OE5XRX/HW-DebugBoard/doc/index.md

---
title: DebugBoard
nav_order: 1
parent: Hardware
---

# DebugBoard PCB

<table>
  <tr><th>Top</th><th>Bottom</th></tr>
  <tr>
    <td>top</td>
    <td>bottom</td>
  </tr>
</table>

Some Text

## Daten

- [Schaltplan]({{ site.data.project.name }}-schematic.pdf)
- [BOM]({{ site.data.project.name }}-bom.html)
- [iBOM]({{ site.data.project.name }}-ibom.html)
- [JLCPCB fabrication & stencil](JLCPCB/{{ site.data.project.name }}-_JLCPCB_compress.zip)
- [JLCPCB Bom](JLCPCB/{{ site.data.project.name }}_bom_jlc.csv)
- [JLCPCB Pick&Place](JLCPCB/{{ site.data.project.name }}_cpl_jlc.csv)
