OE5XRX/HW-DebugBoard/DebugBoard.kicad_sch

## KiCad design DebugBoard.kicad_sch (2026-05-12)

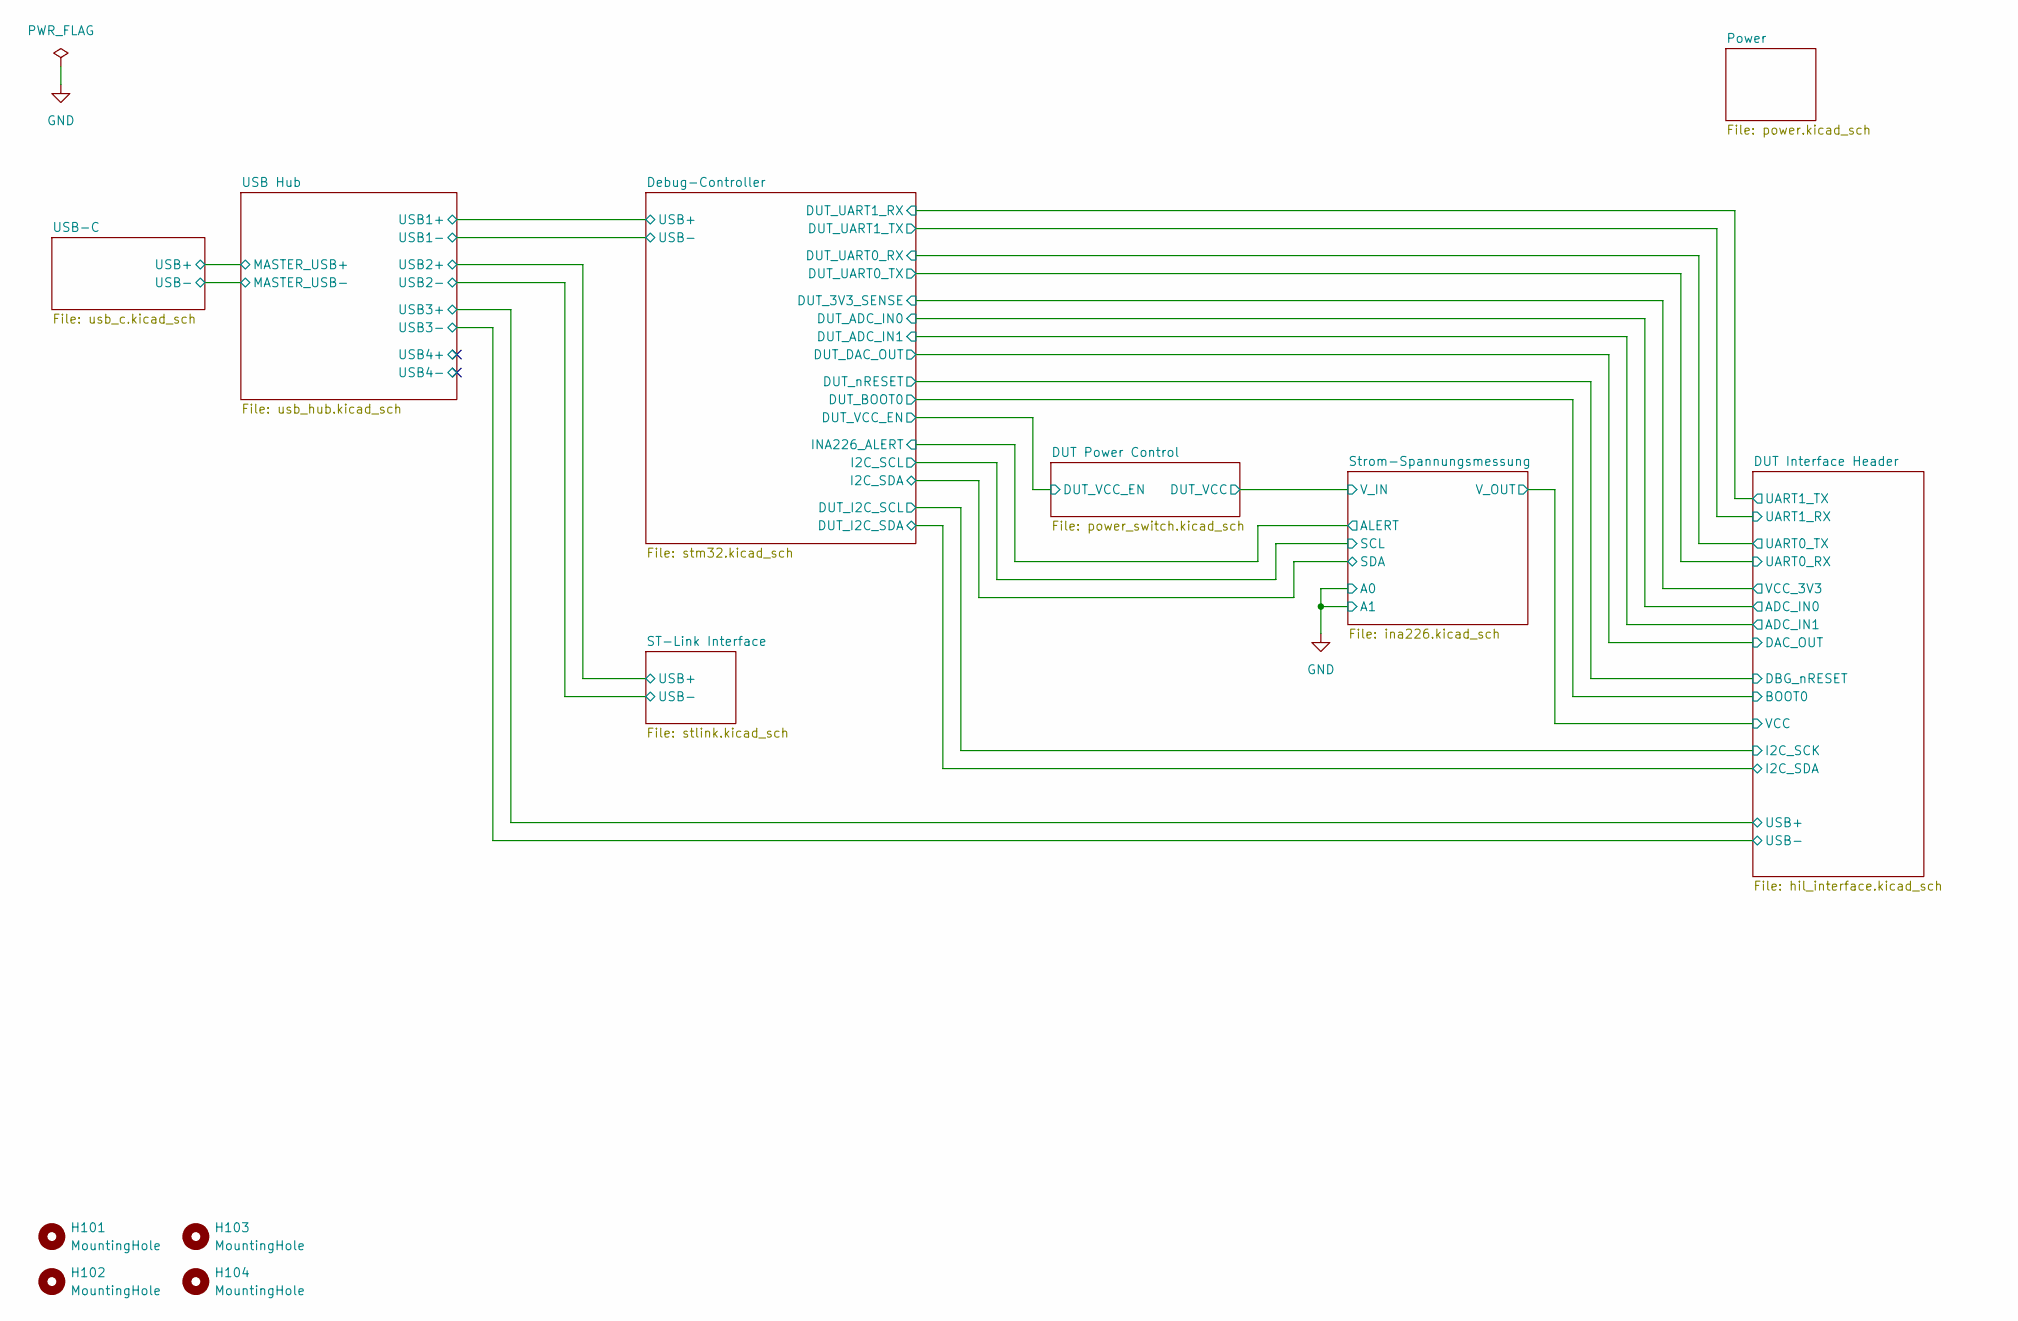
[picture p1: schematic DebugBoard.kicad_sch]

Parts:
H101, H102, H103, H104: MountingHole; MountingHole_3.2mm_M3
