OE5XRX/HW-DebugBoard/hil_interface.kicad_sch

## KiCad design hil_interface.kicad_sch (2026-05-12)

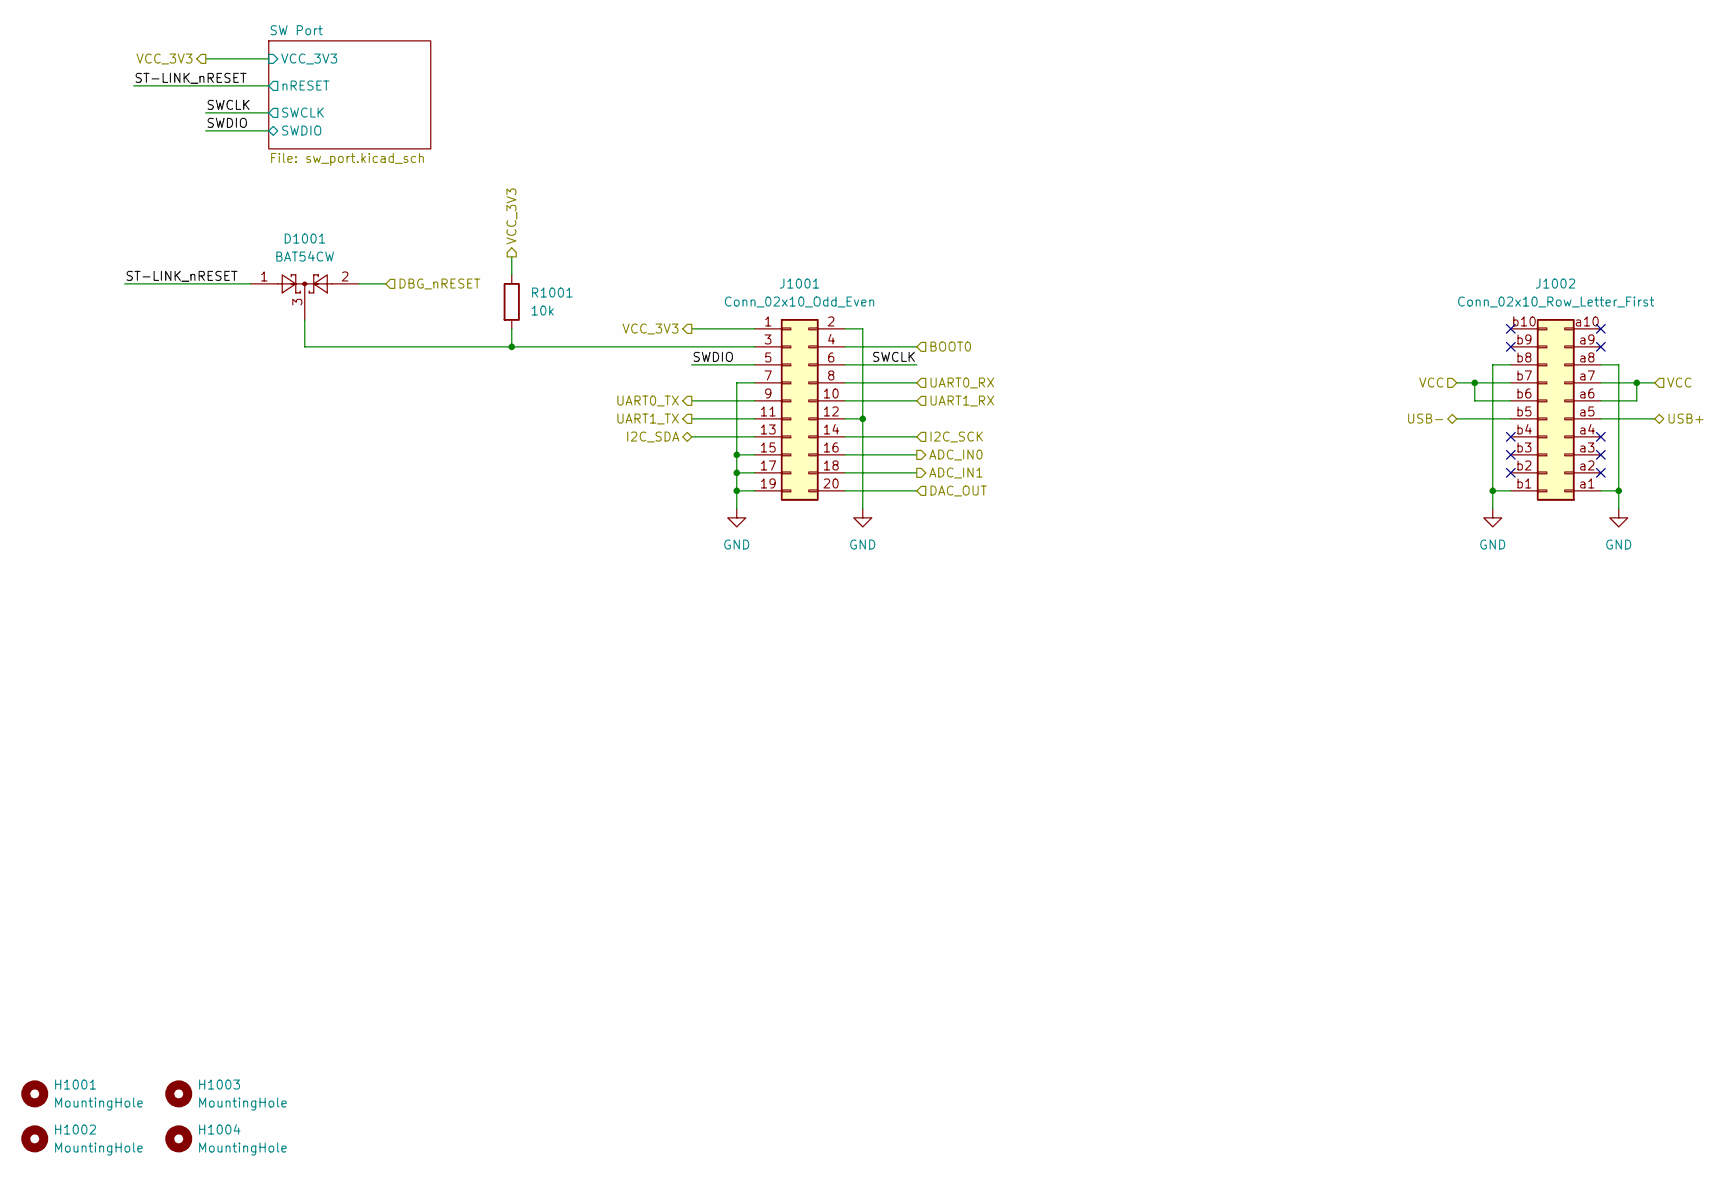
[picture p2: schematic hil_interface.kicad_sch]

Parts:
D1001: BAT54CW; SOT-323_SC-70
H1001, H1002, H1003, H1004: MountingHole; MountingHole_3.2mm_M3
J1001: Conn_02x10_Odd_Even
J1002: Conn_02x10_Row_Letter_First; PCN10-20P-2.54DS; MOUSER 798-PCN1020P254DS72
R1001: 10k; R_0805_2012Metric

Connections:
ADC_IN0: J1001.16
ADC_IN1: J1001.18
BOOT0: J1001.4
DAC_OUT: J1001.20
DBG_nRESET: D1001.2
GND: J1001.2, J1001.7, J1001.12, J1001.15, J1001.17, J1001.19, J1002.a1, J1002.a8, J1002.b1, J1002.b8
I2C_SCK: J1001.14
I2C_SDA: J1001.13
unnamed: D1001.3, J1001.3, R1001.2
ST-LINK_nRESET: D1001.1
SWCLK: J1001.6
SWDIO: J1001.5
UART0_RX: J1001.8
UART0_TX: J1001.9
UART1_RX: J1001.10
UART1_TX: J1001.11
USB+: J1002.a5
USB-: J1002.b5
VCC: J1002.a6, J1002.a7, J1002.b6, J1002.b7
VCC_3V3: J1001.1, R1001.1
