OE5XRX/HW-DebugBoard/ina226.kicad_sch

## KiCad design ina226.kicad_sch (2026-05-12)

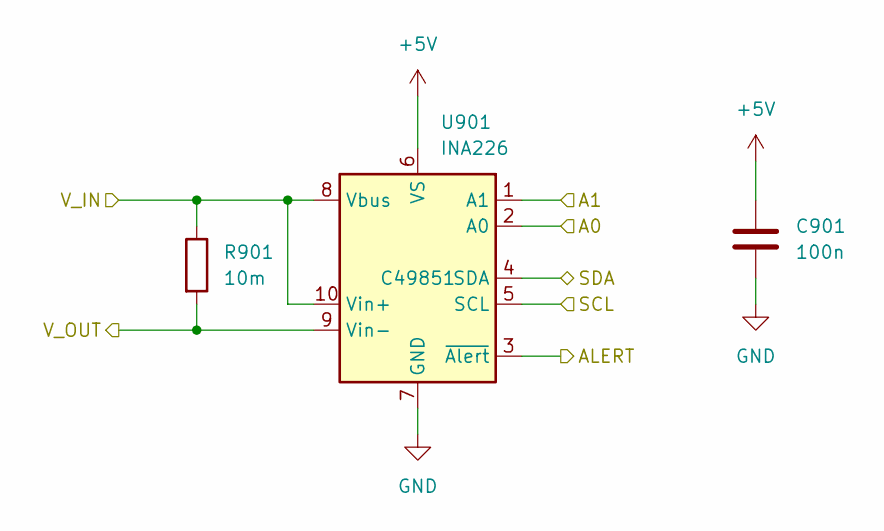
[picture p3: schematic ina226.kicad_sch]

Parts:
C901: 100n; C_0805_2012Metric; LCSC C28233
R901: 10m; R_2512_6332Metric; MOUSER 652-CRF2512FZR010ELF
U901: INA226; VSSOP-10_3x3mm_P0.5mm; LCSC C49851

Connections:
+5V: C901.1, U901.6 (VS)
A0: U901.2 (A0)
A1: U901.1 (A1)
ALERT: U901.3 (~Alert)
GND: C901.2, U901.7 (GND)
SCL: U901.5 (SCL)
SDA: U901.4 (SDA)
V_IN: R901.1, U901.8 (Vbus), U901.10 (Vin+)
V_OUT: R901.2, U901.9 (Vin-)
