OE5XRX/HW-DebugBoard/power.kicad_sch

## KiCad design power.kicad_sch (2026-05-12)

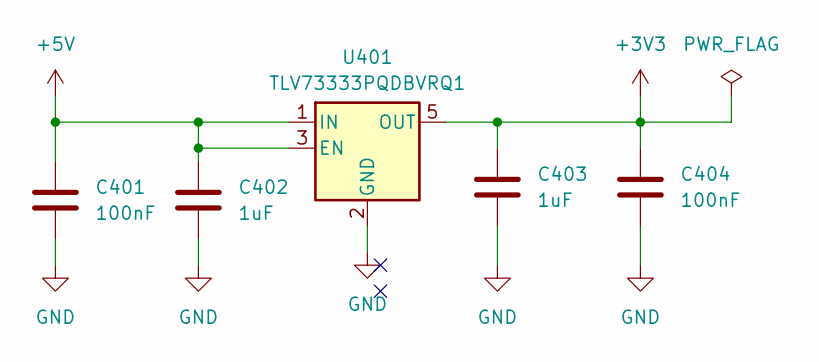
[picture p4: schematic power.kicad_sch]

Parts:
C401, C404: 100nF; C_0805_2012Metric; LCSC C28233
C402, C403: 1uF; C_0805_2012Metric; MOUSER 791-0805B105K250CT
U401: TLV73333PQDBVRQ1; SOT-23-5; LCSC C2862550

Connections:
+3V3: C403.1, C404.2, U401.5 (OUT)
+5V: C401.2, C402.1, U401.1 (IN), U401.3 (EN)
GND: C401.1, C402.2, C403.2, C404.1, U401.2 (GND)
