OE5XRX/HW-DebugBoard/power_switch.kicad_sch

## KiCad design power_switch.kicad_sch (2026-05-12)

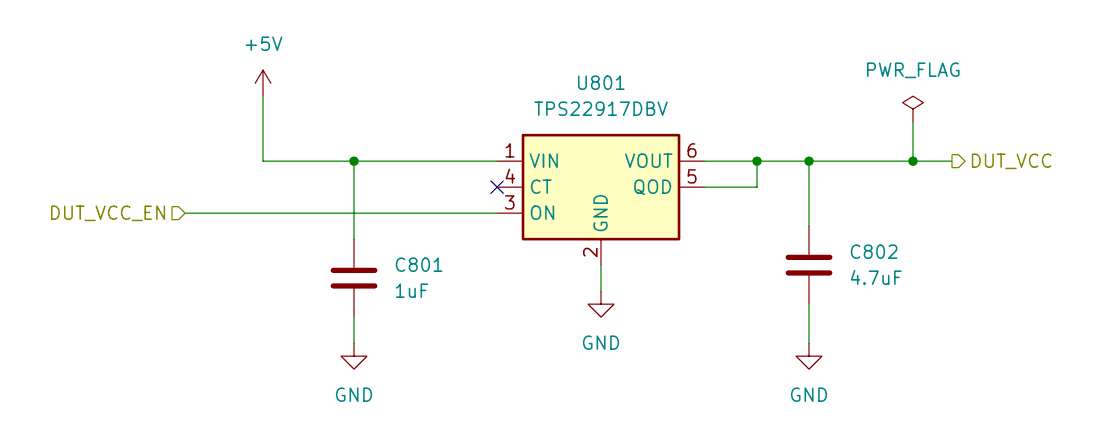
[picture p5: schematic power_switch.kicad_sch]

Parts:
C801: 1uF; C_0805_2012Metric; MOUSER 791-0805B105K250CT
C802: 4.7uF; C_0805_2012Metric; MOUSER 791-0805B105K250CT
U801: TPS22917DBV; SOT-23-6

Connections:
+5V: C801.1, U801.1 (VIN)
DUT_VCC: C802.1, U801.5 (QOD), U801.6 (VOUT)
DUT_VCC_EN: U801.3 (ON)
GND: C801.2, C802.2, U801.2 (GND)
