OE5XRX/HW-DebugBoard/stm32.kicad_sch

## KiCad design stm32.kicad_sch (2026-05-12)

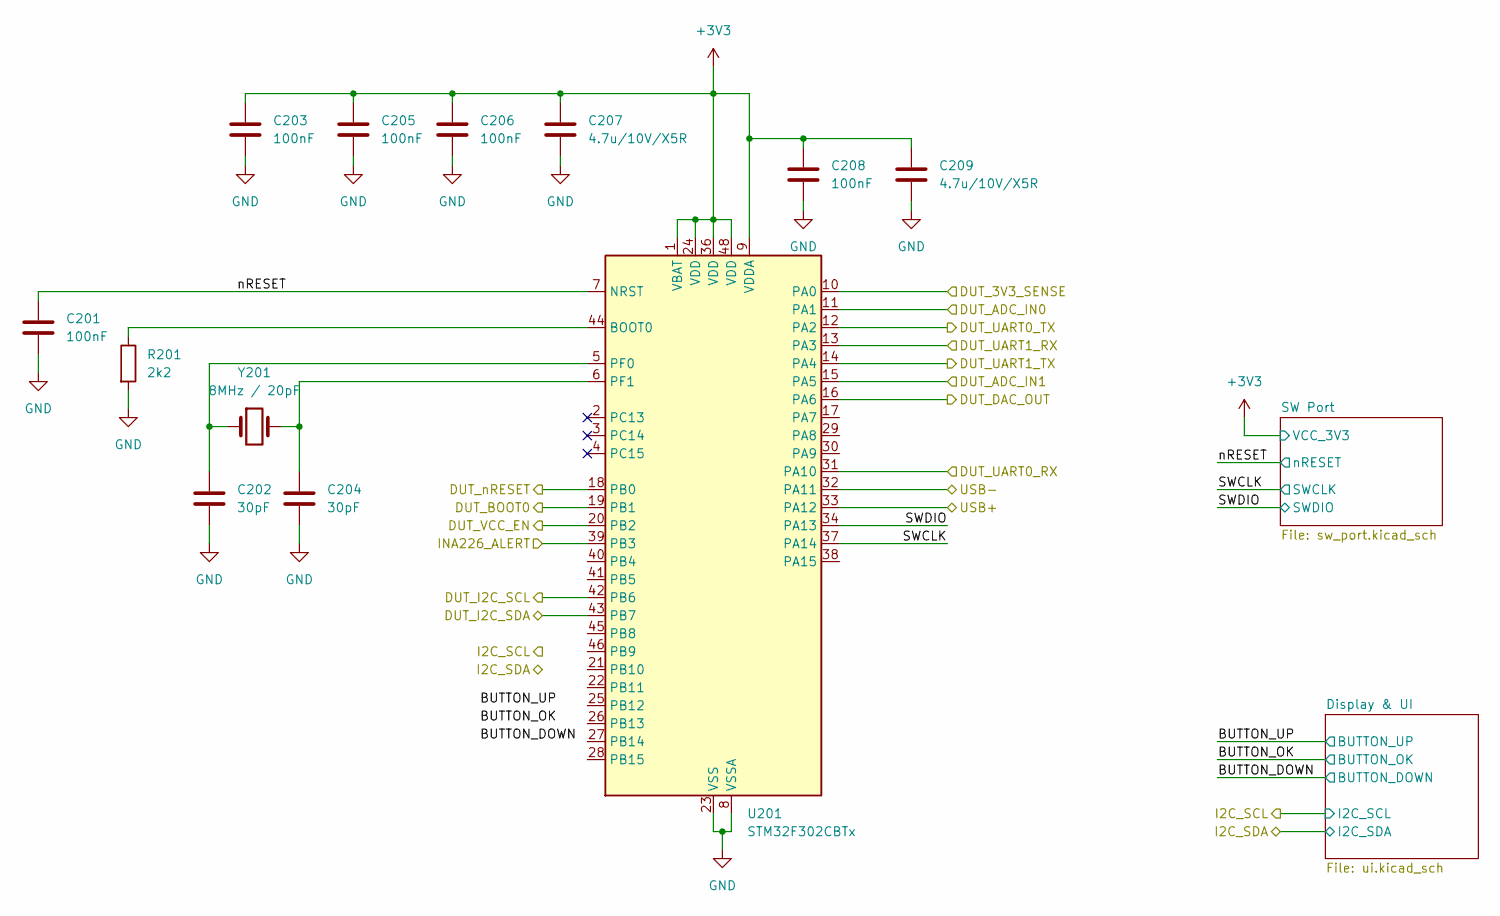
[picture p6: schematic stm32.kicad_sch]

Parts:
C201, C203, C205, C206, C208: 100nF; C_0805_2012Metric; LCSC C28233
C202, C204: 30pF; C_0805_2012Metric; MOUSER 791-0805N300J500CT
C207, C209: 4.7u/10V/X5R; C_0805_2012Metric; MOUSER 187-CL21A475KAQNNNF
R201: 2k2; R_0805_2012Metric; LCSC C17520
U201: STM32F302CBTx; LQFP-48_7x7mm_P0.5mm; MOUSER 511-STM32F302CBT7
Y201: 8MHz / 20pF; Crystal_SMD_HC49-SD; MOUSER 73-XT49M800-20

Connections:
+3V3: C203.2, C205.2, C206.2, C207.2, C208.2, C209.2, U201.1 (VBAT), U201.9 (VDDA), U201.24 (VDD), U201.36 (VDD), U201.48 (VDD)
DUT_3V3_SENSE: U201.10 (PA0)
DUT_ADC_IN0: U201.11 (PA1)
DUT_ADC_IN1: U201.15 (PA5)
DUT_BOOT0: U201.19 (PB1)
DUT_DAC_OUT: U201.16 (PA6)
DUT_I2C_SCL: U201.42 (PB6)
DUT_I2C_SDA: U201.43 (PB7)
DUT_UART0_RX: U201.31 (PA10)
DUT_UART0_TX: U201.12 (PA2)
DUT_UART1_RX: U201.13 (PA3)
DUT_UART1_TX: U201.14 (PA4)
DUT_VCC_EN: U201.20 (PB2)
DUT_nRESET: U201.18 (PB0)
GND: C201.2, C202.2, C203.1, C204.2, C205.1, C206.1, C207.1, C208.1, C209.1, R201.2, U201.8 (VSSA), U201.23 (VSS), U201.35 (VSS), U201.47 (VSS)
INA226_ALERT: U201.39 (PB3)
unnamed: C202.1, U201.5 (PF0), Y201.1
unnamed: C204.1, U201.6 (PF1), Y201.2
unnamed: R201.1, U201.44 (BOOT0)
SWCLK: U201.37 (PA14)
SWDIO: U201.34 (PA13)
USB+: U201.33 (PA12)
USB-: U201.32 (PA11)
nRESET: C201.1, U201.7 (NRST)
