OE5XRX/HW-DebugBoard/ui.kicad_sch

## KiCad design ui.kicad_sch (2026-05-12)

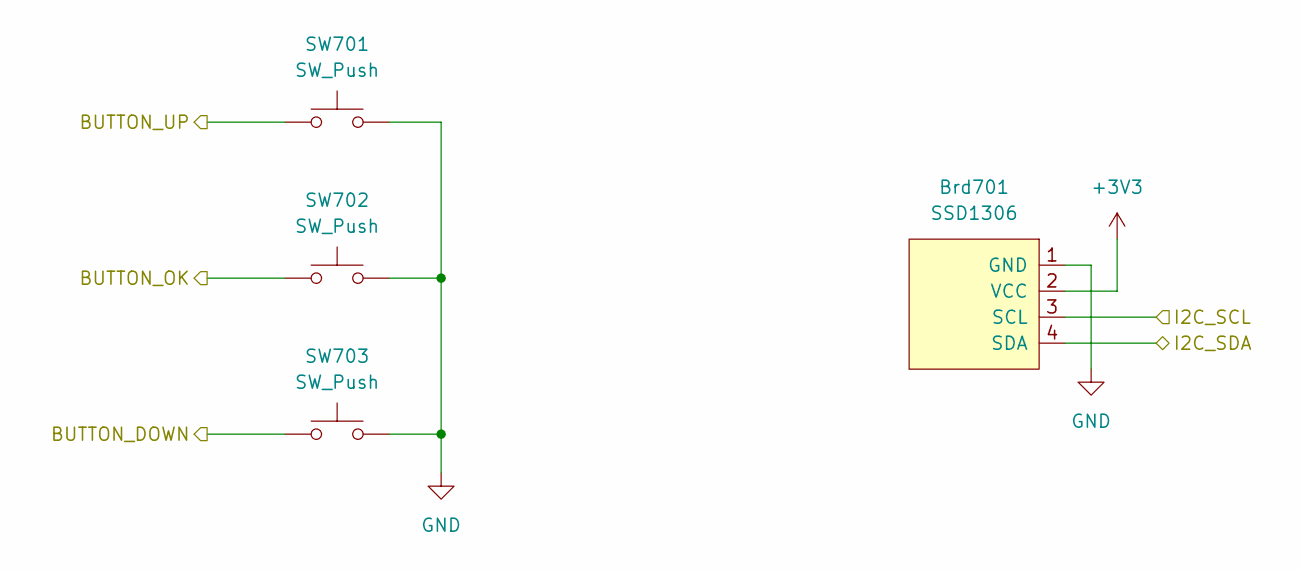
[picture p7: schematic ui.kicad_sch]

Parts:
Brd701: SSD1306; 128x64OLED
SW701, SW702, SW703: SW_Push

Connections:
+3V3: Brd701.2 (VCC)
BUTTON_DOWN: SW703.1
BUTTON_OK: SW702.1
BUTTON_UP: SW701.1
GND: Brd701.1 (GND), SW701.2, SW702.2, SW703.2
I2C_SCL: Brd701.3 (SCL)
I2C_SDA: Brd701.4 (SDA)
