OE5XRX/HW-DebugBoard/usb_c.kicad_sch

## KiCad design usb_c.kicad_sch (2026-05-12)

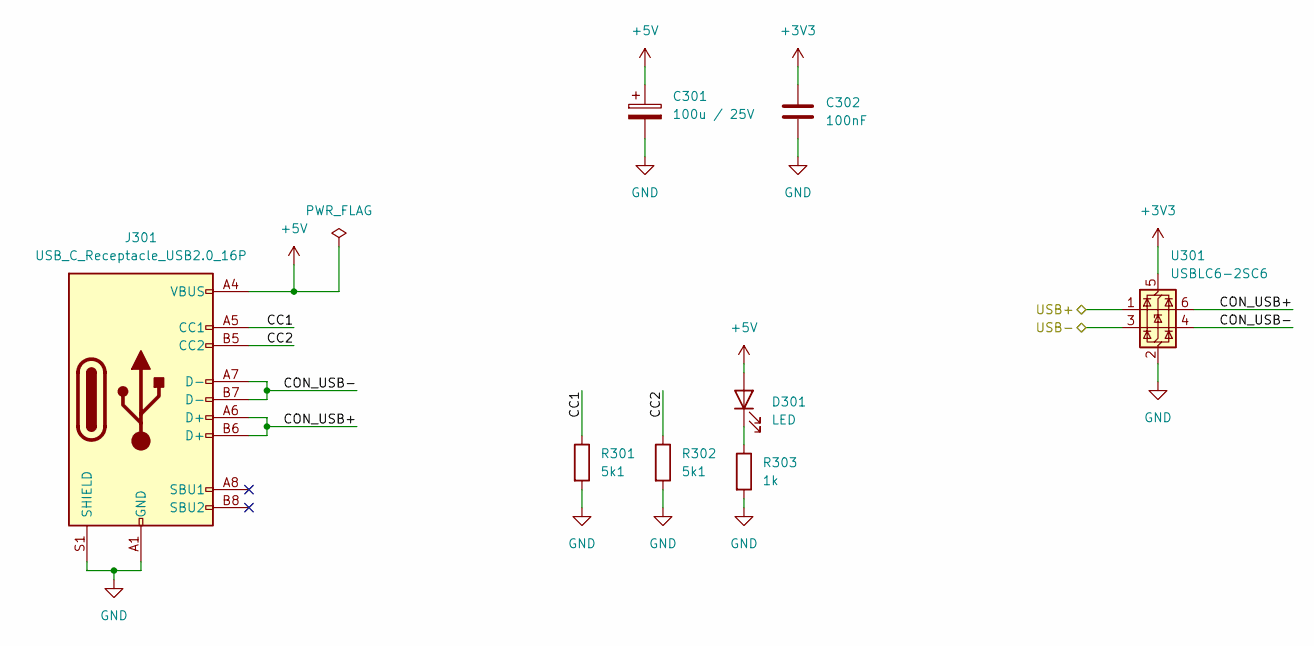
[picture p8: schematic usb_c.kicad_sch]

Parts:
C301: 100u / 25V; CP_EIA-7343-43_Kemet-X; LCSC C132558
C302: 100nF; C_0805_2012Metric; LCSC C28233
D301: LED; LED_0805_2012Metric; LCSC C84256
J301: USB_C_Receptacle_USB2.0_16P; USB_C_Receptacle_G-Switch_GT-USB-7010ASV; LCSC C2988369
R301, R302: 5k1; R_0805_2012Metric; LCSC C27834
R303: 1k; R_0805_2012Metric; LCSC C17513
U301: USBLC6-2SC6; SOT-23-6; LCSC C2827654

Connections:
+3V3: C302.1, U301.5 (VBUS)
+5V: C301.1, D301.2 (A), J301.A4 (VBUS), J301.A9 (VBUS), J301.B4 (VBUS), J301.B9 (VBUS)
CC1: J301.A5 (CC1), R301.1
CC2: J301.B5 (CC2), R302.1
CON_USB+: J301.A6 (D+), J301.B6 (D+), U301.6 (I/O1)
CON_USB-: J301.A7 (D-), J301.B7 (D-), U301.4 (I/O2)
GND: C301.2, C302.2, J301.A1 (GND), J301.A12 (GND), J301.B1 (GND), J301.B12 (GND), J301.S1 (SHIELD), R301.2, R302.2, R303.2, U301.2 (GND)
unnamed: D301.1 (K), R303.1
USB+: U301.1 (I/O1)
USB-: U301.3 (I/O2)
