OE5XRX/HW-DebugBoard/usb_hub.kicad_sch

## KiCad design usb_hub.kicad_sch (2026-05-12)

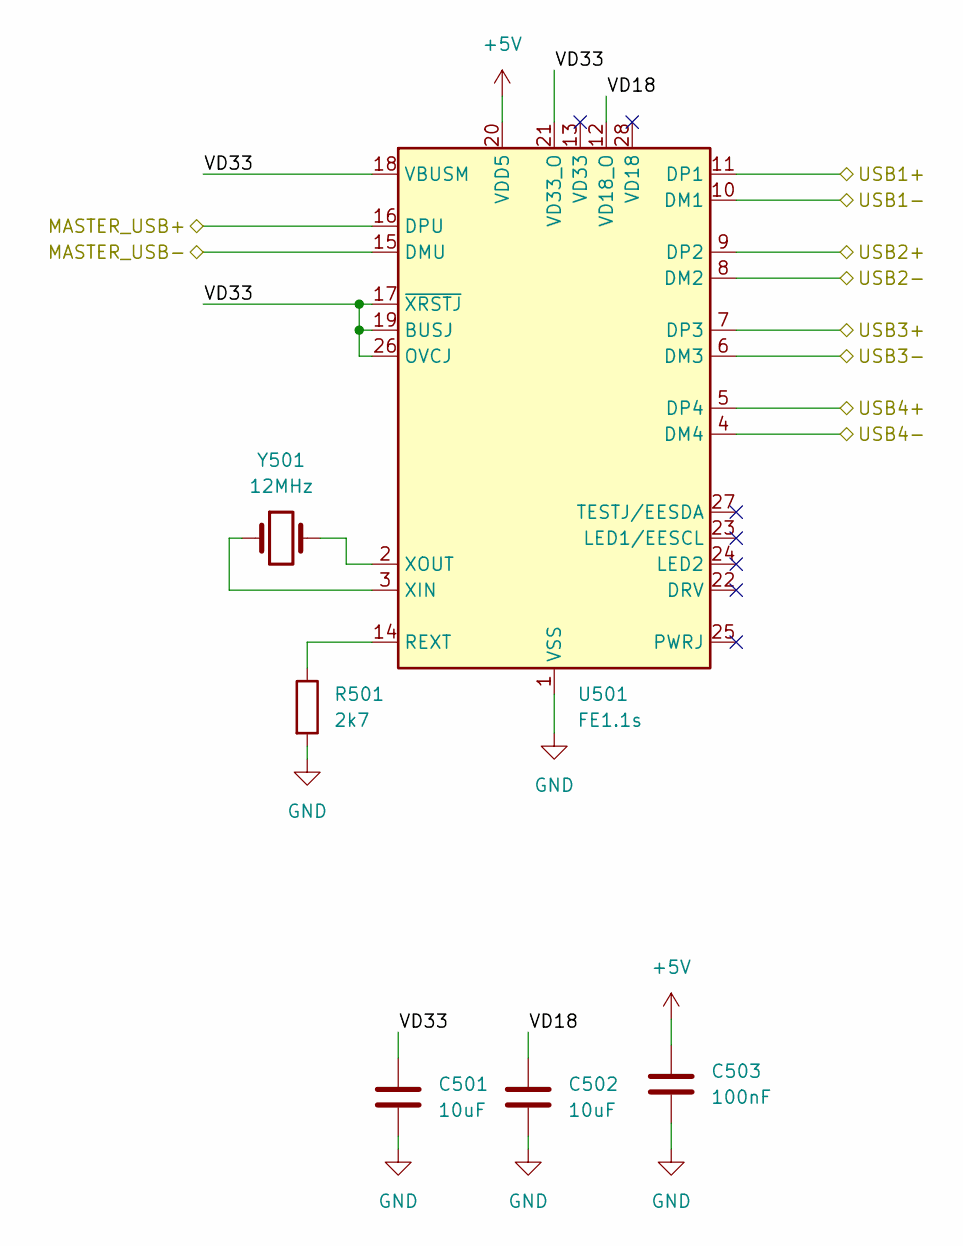
[picture p9: schematic usb_hub.kicad_sch]

Parts:
C501, C502: 10uF; C_0805_2012Metric; LCSC C13585
C503: 100nF; C_0805_2012Metric; LCSC C28233
R501: 2k7; R_0805_2012Metric; LCSC C352230
U501: FE1.1s; SSOP-28_3.9x9.9mm_P0.635mm; LCSC C6706491
Y501: 12MHz; M49S-SMD; LCSC C2983432

Connections:
+5V: C503.1, U501.20 (VDD5)
GND: C501.2, C502.2, C503.2, R501.2, U501.1 (VSS)
MASTER_USB+: U501.16 (DPU)
MASTER_USB-: U501.15 (DMU)
unnamed: R501.1, U501.14 (REXT)
unnamed: U501.2 (XOUT), Y501.2
unnamed: U501.3 (XIN), Y501.1
USB1+: U501.11 (DP1)
USB1-: U501.10 (DM1)
USB2+: U501.9 (DP2)
USB2-: U501.8 (DM2)
USB3+: U501.7 (DP3)
USB3-: U501.6 (DM3)
USB4+: U501.5 (DP4)
USB4-: U501.4 (DM4)
VD18: C502.1, U501.12 (VD18_O)
VD33: C501.1, U501.17 (~XRSTJ), U501.18 (VBUSM), U501.19 (BUSJ), U501.21 (VD33_O), U501.26 (OVCJ)
