OE5XRX/HW-DebugBoard/(commit log)

2026-01-06 add first KiCad version
    [main.kicad_pcb, main.kicad_sch, power.kicad_sch, stm32.kicad_sch, usb_c.kicad_sch]
2026-01-06 add basic structure, update readme
    [hil_interface.kicad_sch, ina226.kicad_sch, main.kicad_sch, power_switch.kicad_sch, stlink.kicad_sch, stm32.kicad_sch, ui.kicad_sch, usb_c.kicad_sch]
2026-01-08 Update schematic for DebugBoard with connector and power symbols.
    [hil_interface.kicad_sch, ina226.kicad_sch, main.kicad_sch, power_switch.kicad_sch, stlink.kicad_sch, stm32.kicad_sch, sw_port.kicad_sch]
2026-01-10 Update USB-C and USB-Hub Schematics with New Titles and Reference Changes
    - Changed title from "DebugBoard" to "USB-C" in usb_c.kicad_sch.
    - Changed title from "DebugBoard" to "USB-Hub" in usb_hub.kicad_sch.
    - Updated multiple component references in usb_c.kicad_sch to new identifiers (#PWR0301 to #PWR0312, D301, U301, etc.).
    - Updated component reference from "R103" to "R501" in usb_hub.kicad_sch.
    [hil_interface.kicad_sch, ina226.kicad_sch, main.kicad_sch, power.kicad_sch, power_switch.kicad_sch, stlink.kicad_sch, stm32.kicad_sch, sw_port.kicad_sch]
2026-05-12 rename(kicad): main.kicad_* → DebugBoard.kicad_*
    [DebugBoard.kicad_pcb, DebugBoard.kicad_sch, hil_interface.kicad_sch, ina226.kicad_sch, power.kicad_sch, power_switch.kicad_sch, stm32.kicad_sch, sw_port.kicad_sch]
