OE5XRX/HW-DebugBoard/(notices)

Notices in the files:
README.md:
License: CERN-OHL-S
